ttyaaron/ME218B_Lab8/README.md

# ME218B_Lab8
lab 8 repository for ME218B lab 8
