ttyaaron/ME218B_Lab8/KiCad/Lab8/Lab8.pdf

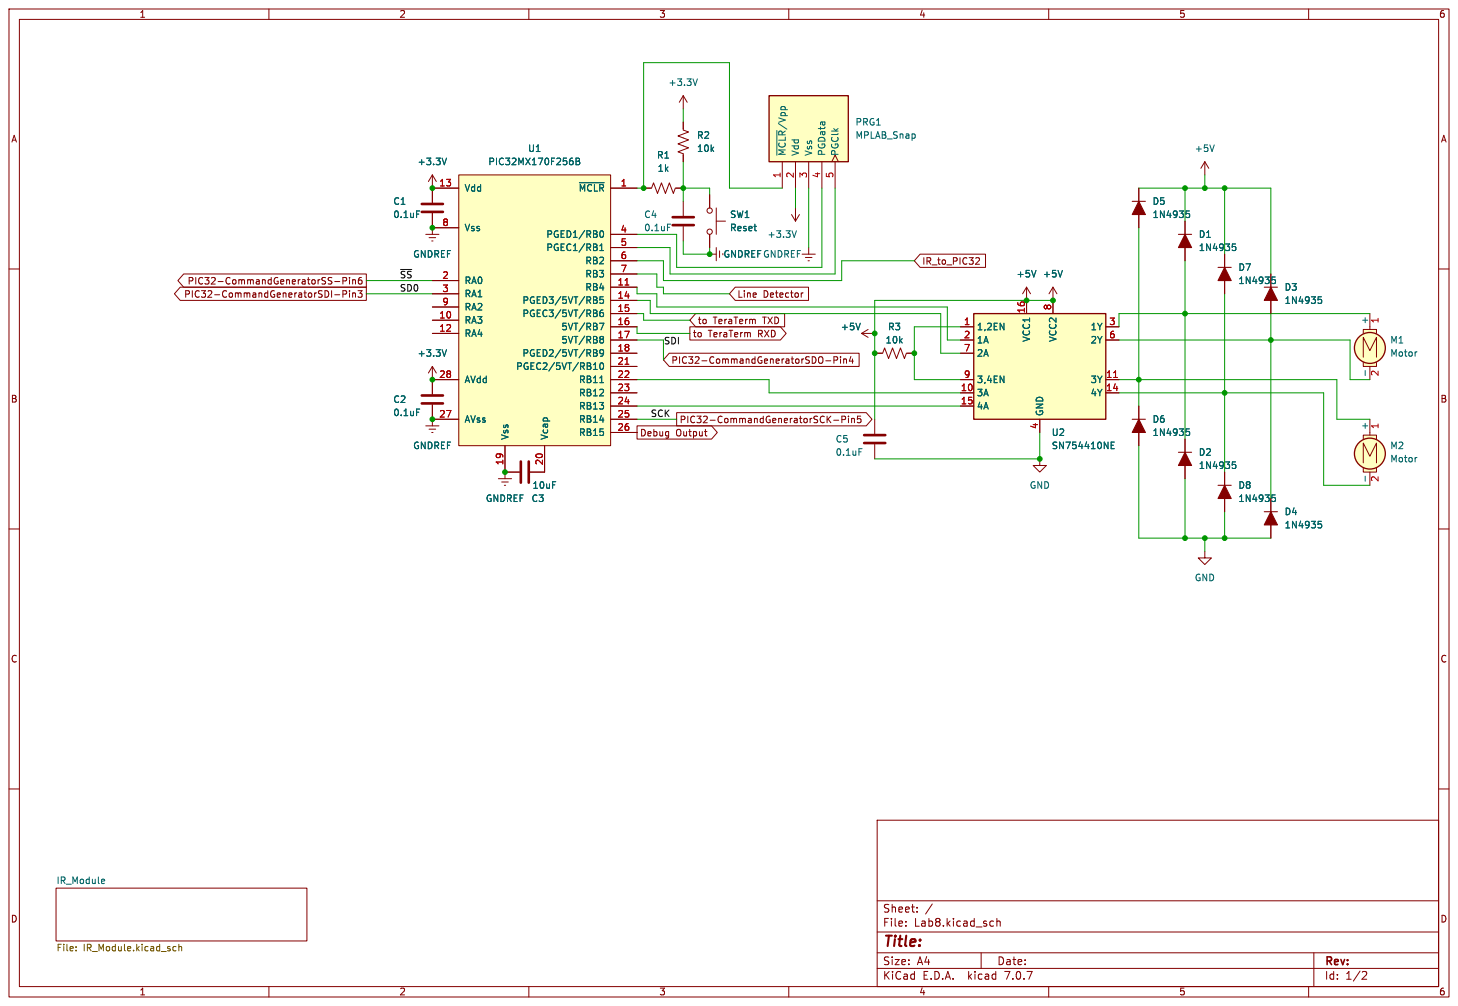
[picture p13: page 1]

10k Debug Output PIC32-CommandGeneratorSDI-Pin3 PIC32-CommandGeneratorSS-Pin6

Id: 1/2 Title: File: Lab8.kicad_sch Sheet: /

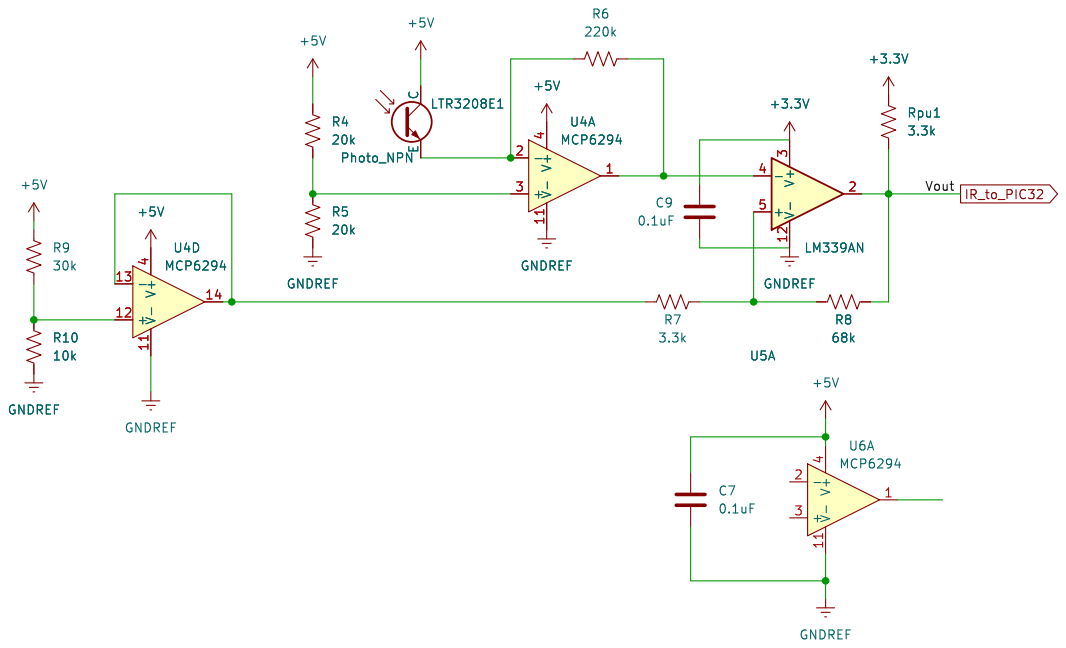
[picture p14: page 2]
