ttyaaron/ME218B_Lab8/(commit log)

2026-02-03 Initial import of EventService Framework
    [Lab8.kicad_pcb, Lab8.kicad_sch]
2026-02-03 Update peoject KiCad schematics
    [IR_Module.kicad_sch, Lab8.kicad_sch, Line_Detection_Module.kicad_sch, SPI_Module.kicad_sch]
2026-02-03 Add in report draft, wire IR in schematics
    [Lab8.kicad_sch]
2026-02-04 Added SPI_HAL & modified it to allow for SPI reads; made some additional comments & data structures related to commands
2026-02-04 Update KiCad, code up beacon detection event checker, disable BeaconDetectService in the project for now
    [IR_Module.kicad_sch]
2026-02-04 Complete beacon detection wiring, coding and testing
    [IR_Module.kicad_sch, Lab8.kicad_sch]
2026-02-05 Update SPI wiring and implement line detection capture
    [Lab8.kicad_sch]
2026-02-05 Revert "Update SPI wiring and implement line detection capture"
    This reverts commit 9cbd4223595eda152b008ae8c730017f89a32266.
    [Lab8.kicad_sch]
2026-02-05 Revert "Revert "Update SPI wiring and implement line detection capture""
    This reverts commit 9eb00a7cf1ff2e7c6ae798789d116206cfe13d70.
    [Lab8.kicad_sch]
2026-02-05 Fixed SPI Code and now working with Command Generator - Dylan
2026-02-05 Motor Command
2026-02-05 wire connect and IR detect and SPI and state machine test pass
    [Lab8.kicad_sch]
2026-02-05 Fixed bug where it didn't run a received command if it wasn't already in the stopped state
    [MainLogicFSM.c]
2026-02-06 Update submitted report, schematics and pseudocode
